jakechung42/ME557_introRobotics_finalProject/README.md

# ME557_introRobotics_finalProject
This repo is for the final robot arm project of ME557 Introduction to Robotics class.
## Contributors:
- Jake Chung
- Johnathan Le
- Yahye Egal
- Vladi Ruchin

Winter 2020
Portland State University
