jakechung42/ME557_introRobotics_finalProject/MechanicalDesign/penGripper/gripAssm.SLDASM

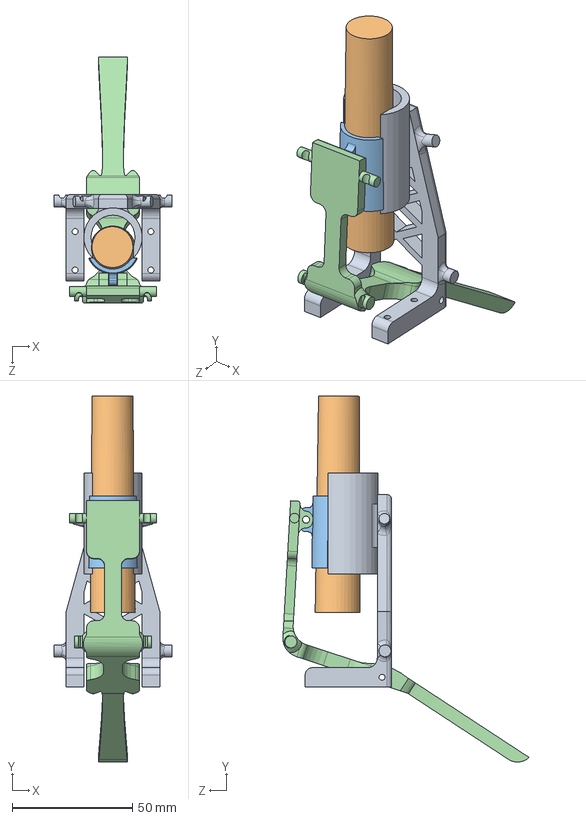
[picture p2: CAD file, 2020-03-06]
MechanicalDesign/penGripper/gripAssm.SLDASM
49.0 x 152.3 x 102.4 mm
penHolder
pen
penSlot
bottomJaw
