jakechung42/ME557_introRobotics_finalProject/MechanicalDesign/base_Yahye/ME457-robotarmBase.SLDPRT

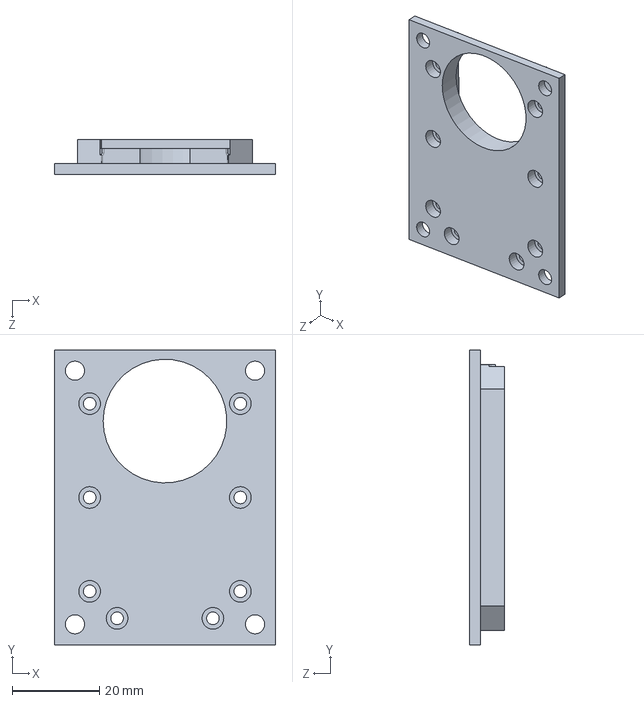
[picture p3: CAD file, 2020-02-05]
MechanicalDesign/base_Yahye/ME457-robotarmBase.SLDPRT
50.9 x 67.7 x 8.00 mm
