jakechung42/ME557_introRobotics_finalProject/MechanicalDesign/links_johnathan/FR07-S101K.SLDPRT

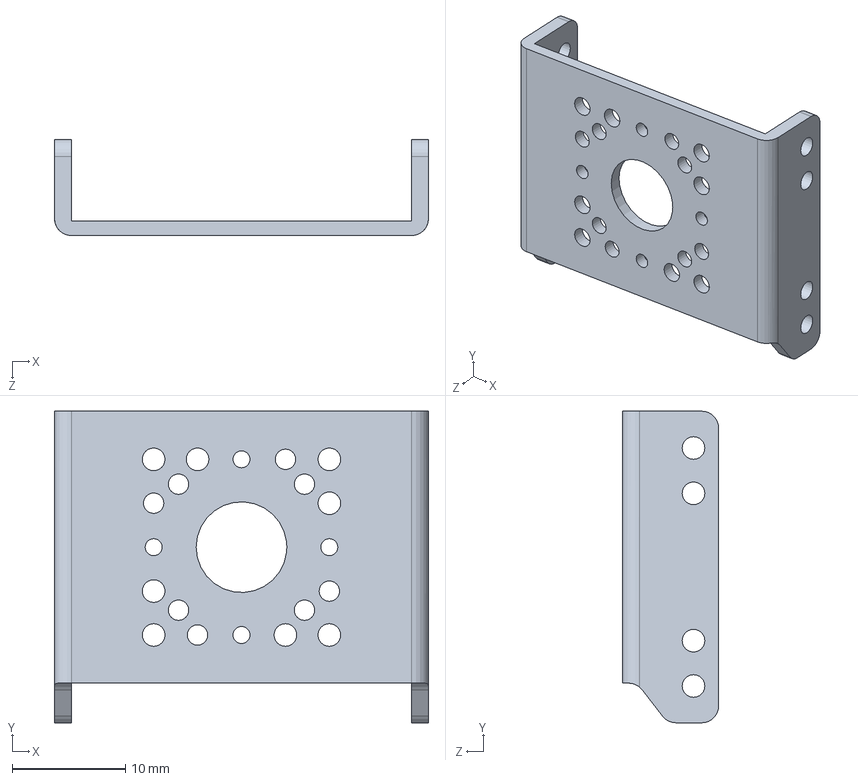
[picture p4: CAD file, 2020-02-05]
MechanicalDesign/links_johnathan/FR07-S101K.SLDPRT
33.0 x 27.5 x 8.50 mm
