jakechung42/ME557_introRobotics_finalProject/MechanicalDesign/links_johnathan/adapter_1.STL

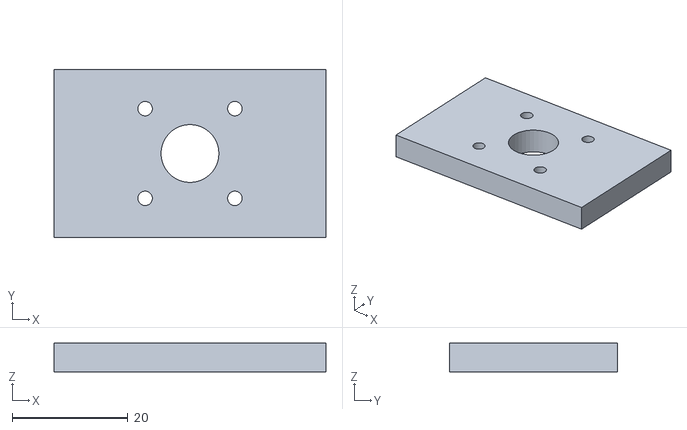
[picture p5: CAD file, 2020-02-05]
MechanicalDesign/links_johnathan/adapter_1.STL
47.0 x 29.0 x 5.00
