jakechung42/ME557_introRobotics_finalProject/MechanicalDesign/penGripper/penHolder.SLDPRT

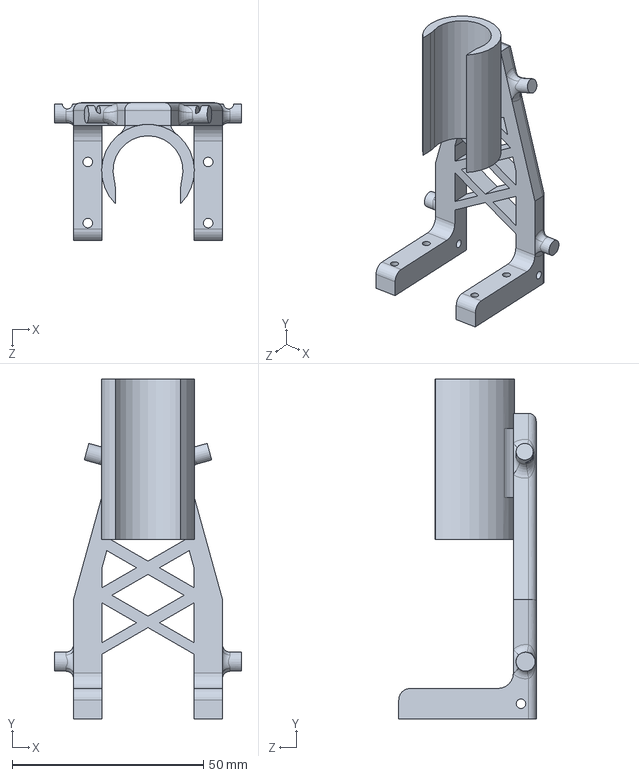
[picture p6: CAD file, 2020-03-06]
MechanicalDesign/penGripper/penHolder.SLDPRT
49.0 x 89.0 x 36.0 mm
