jakechung42/ME557_introRobotics_finalProject/MechanicalDesign/penGripper/bottomJaw.SLDPRT

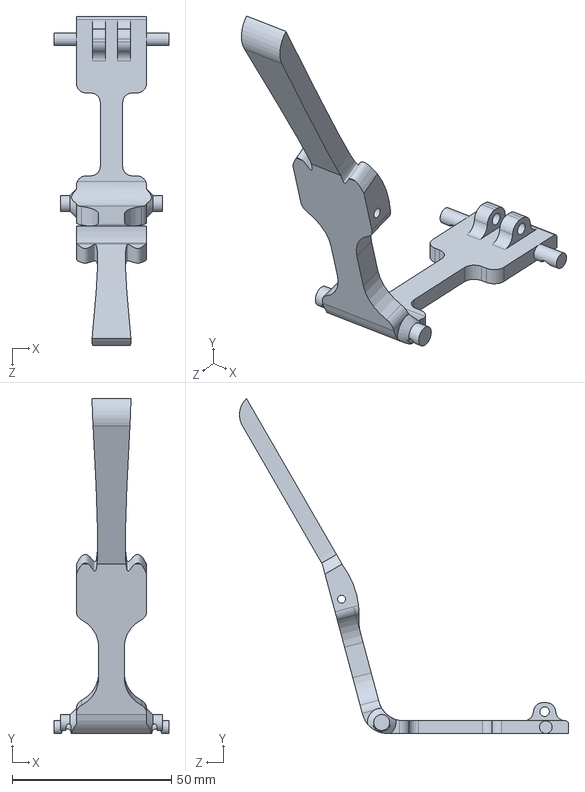
[picture p8: CAD file, 2020-03-06]
MechanicalDesign/penGripper/bottomJaw.SLDPRT
36.0 x 105.1 x 103.2 mm
