jakechung42/ME557_introRobotics_finalProject/MechanicalDesign/links_johnathan/FR05-S101K.SLDPRT

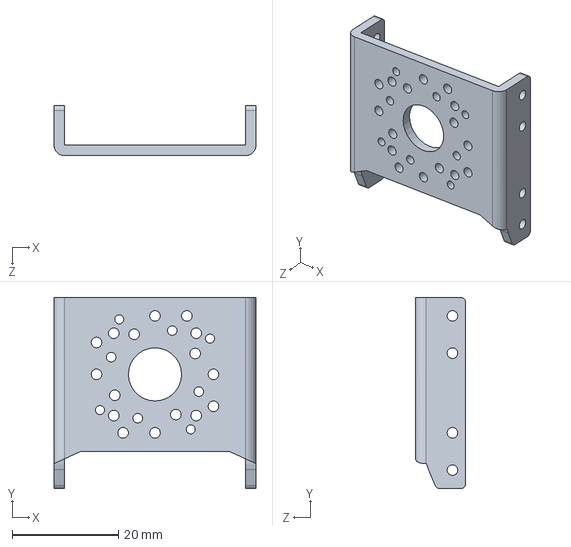
[picture p9: CAD file, 2020-02-05]
MechanicalDesign/links_johnathan/FR05-S101K.SLDPRT
38.0 x 36.0 x 9.50 mm
