jakechung42/ME557_introRobotics_finalProject/MechanicalDesign/penGripper/penSlot.SLDPRT

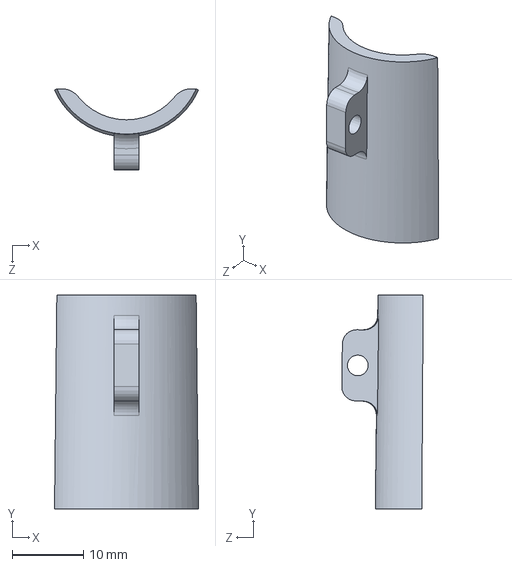
[picture p10: CAD file, 2020-03-06]
MechanicalDesign/penGripper/penSlot.SLDPRT
20.2 x 30.0 x 11.4 mm
