jakechung42/ME557_introRobotics_finalProject/MechanicalDesign/links_johnathan/F2.SLDPRT

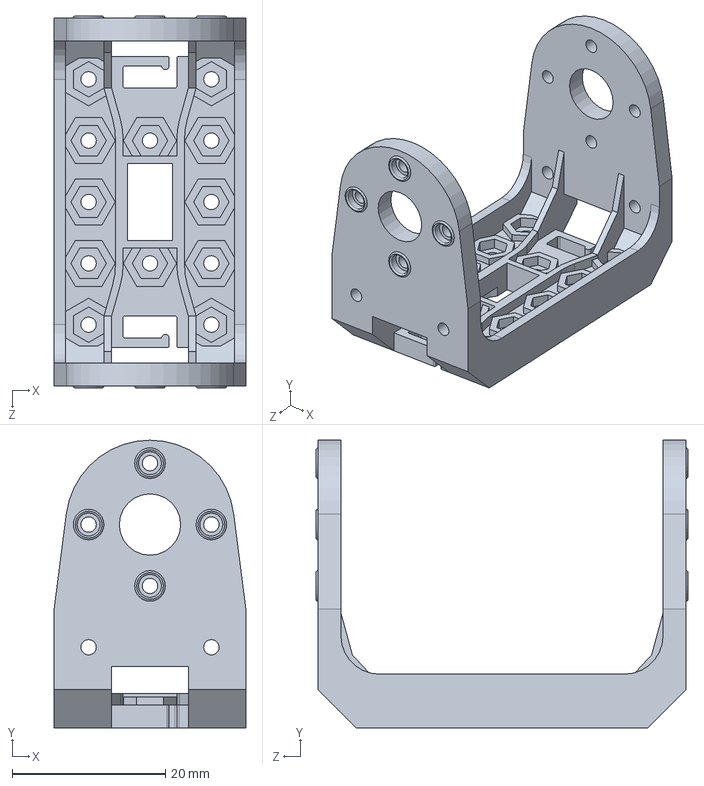
[picture p11: CAD file, 2020-02-05]
MechanicalDesign/links_johnathan/F2.SLDPRT
25.0 x 37.5 x 48.5 mm
