jakechung42/ME557_introRobotics_finalProject/MechanicalDesign/penGripper/testPrint.STL

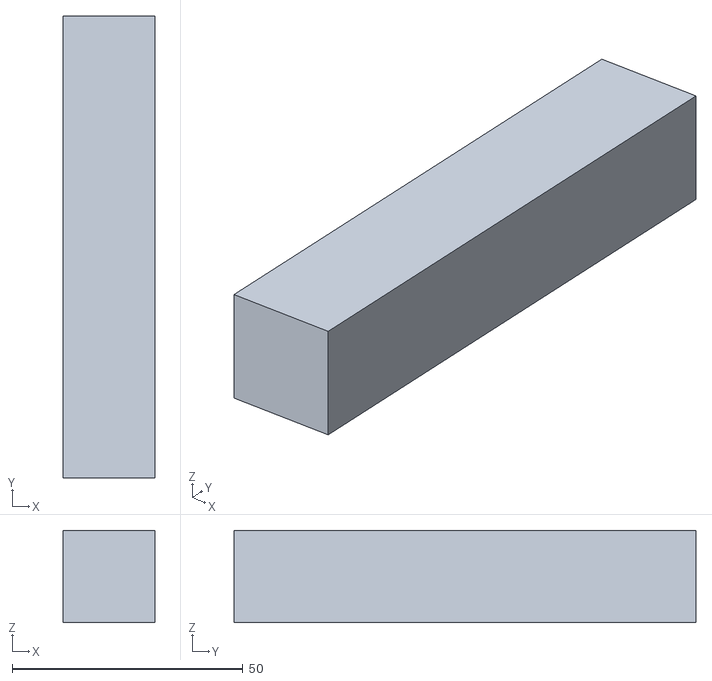
[picture p12: CAD file, 2020-02-17]
MechanicalDesign/penGripper/testPrint.STL
20.0 x 100.0 x 20.0
