jakechung42/ME557_introRobotics_finalProject/MechanicalDesign/links_johnathan/adapter2.SLDPRT

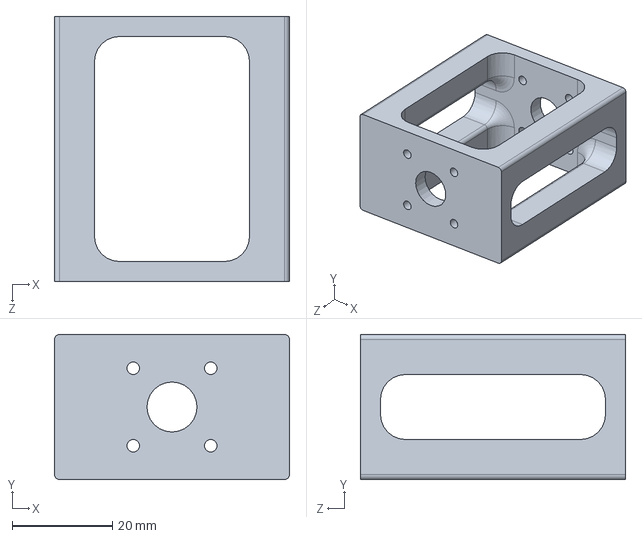
[picture p13: CAD file, 2020-02-05]
MechanicalDesign/links_johnathan/adapter2.SLDPRT
47.0 x 29.0 x 53.0 mm
