jakechung42/ME557_introRobotics_finalProject/MechanicalDesign/penGripper/pen.SLDPRT

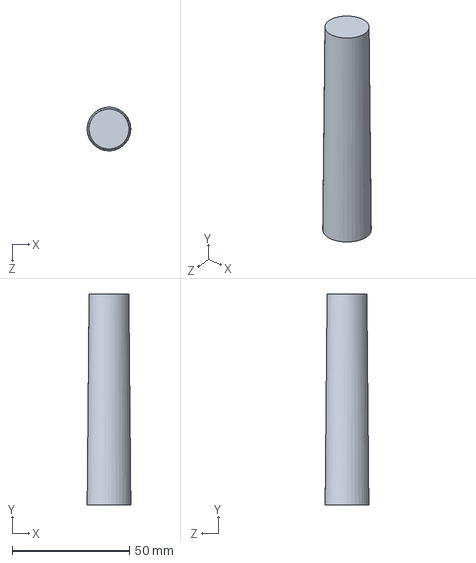
[picture p14: CAD file, 2020-02-05]
MechanicalDesign/penGripper/pen.SLDPRT
18.7 x 90.0 x 18.7 mm
