jakechung42/ME557_introRobotics_finalProject/MechanicalDesign/links_johnathan/Linkv2.STL

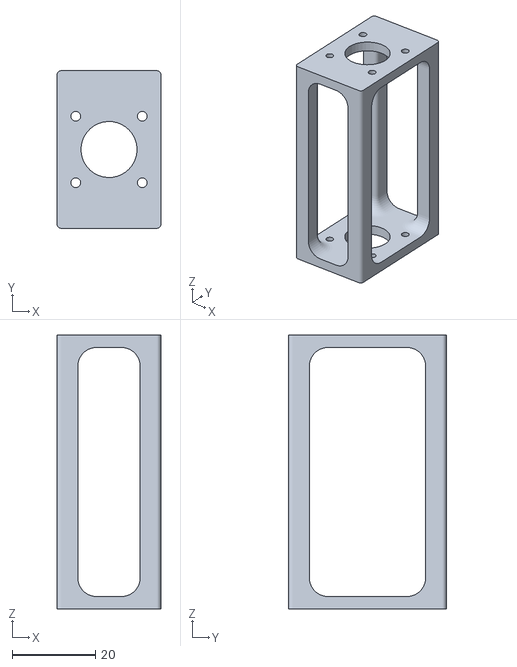
[picture p15: CAD file, 2020-02-05]
MechanicalDesign/links_johnathan/Linkv2.STL
25.0 x 38.0 x 66.0
