jakechung42/ME557_introRobotics_finalProject/(list of files, cad)

Other CAD files:
MechanicalDesign/base_Yahye/ME457-robotarmBase.STL
MechanicalDesign/penGripper/bottomJaw.STL
MechanicalDesign/penGripper/penHolder.STL
MechanicalDesign/penGripper/penSlot.STL
