jakechung42/ME557_introRobotics_finalProject/(commit log)

2020-02-05 initial update
    [F2.SLDPRT, FR05-S101K.SLDPRT, FR07-S101K.SLDPRT, Linkv2.STL, Linkv4.STL, ME457-robotarmBase.SLDPRT, ME457-robotarmBase.STL, adapter2.SLDPRT]
2020-02-05 move stuff around
    [F2.SLDPRT, FR05-S101K.SLDPRT, FR07-S101K.SLDPRT, Linkv2.STL, Linkv4.STL, ME457-robotarmBase.SLDPRT, ME457-robotarmBase.STL, adapter2.SLDPRT]
2020-02-10 new design
    [penHolder.SLDPRT]
2020-02-14 function to control the motor with ID as an input
2020-02-14 arduino file to control the dynamixels
2020-02-14 minor updates figured out that all motors must be connected for the code to work
2020-02-14 home all motors
2020-02-17 this new version check to see if Matlab wants to get position or wants to move the motor
2020-02-17 this Arduino code uses the first byte data to determine if it needs to move or to return angle.
2020-02-27 this code asks the arm to open the clamp
2020-02-28 Johnathan's Code
    [L_A.csv, L_B.csv, L_C.csv, L_D.csv, L_E.csv, L_F.csv, L_G.csv, L_H.csv]
2020-03-02 update to work with 6 motors
2020-03-02 update path
    [L_C.csv, L_E.csv]
2020-03-03 rather than using the current position to load path, posSet is not reliable so going to use a preset position
2020-03-06 update new design
    [bottomJaw.SLDPRT, bottomJaw.STL, gripAssm.SLDASM, penHolder.SLDPRT, penHolder.STL, penSlot.SLDPRT]
